steamcheng/esp8266_attic_monitor/schematics/Attic Monitor v3_schem.pdf

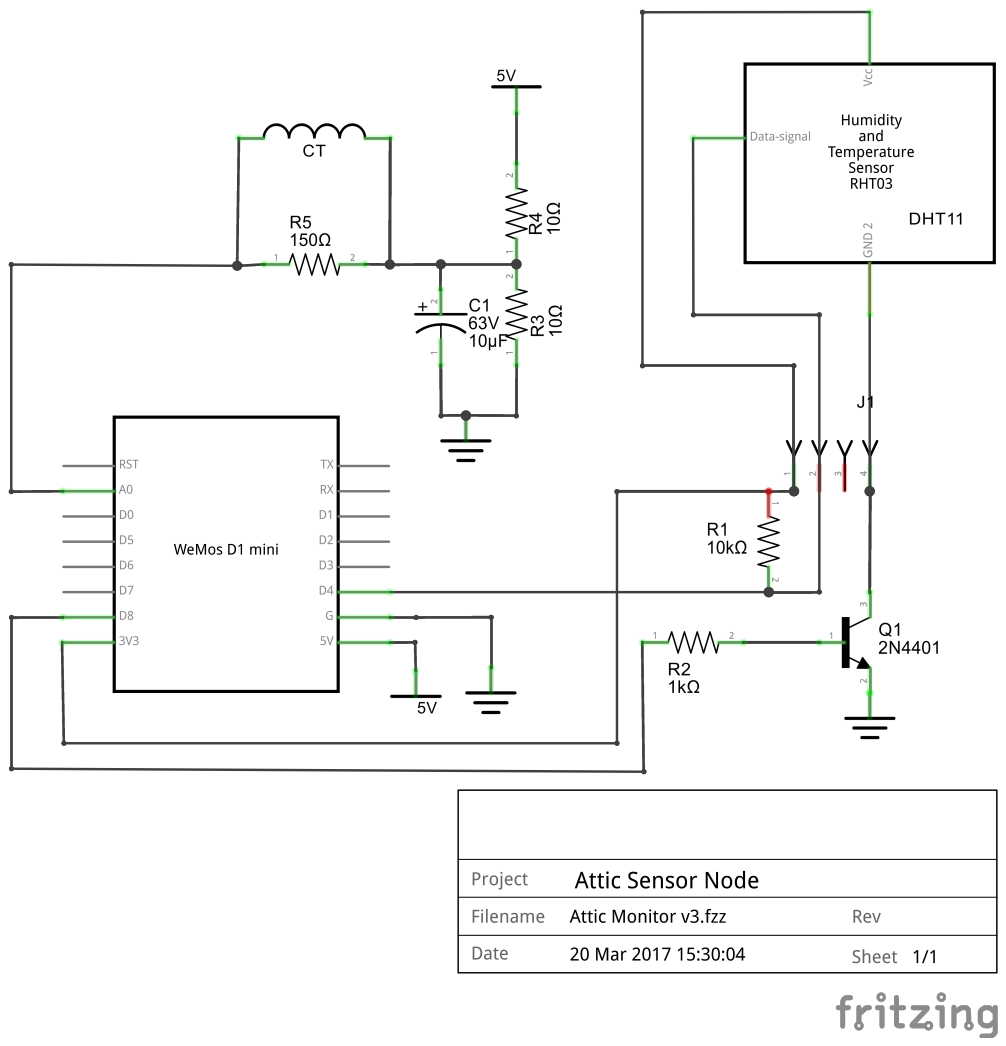
[picture p1: page 1]
