steamcheng/esp8266_attic_monitor/schematics/Attic Monitor Sketch_schem.pdf

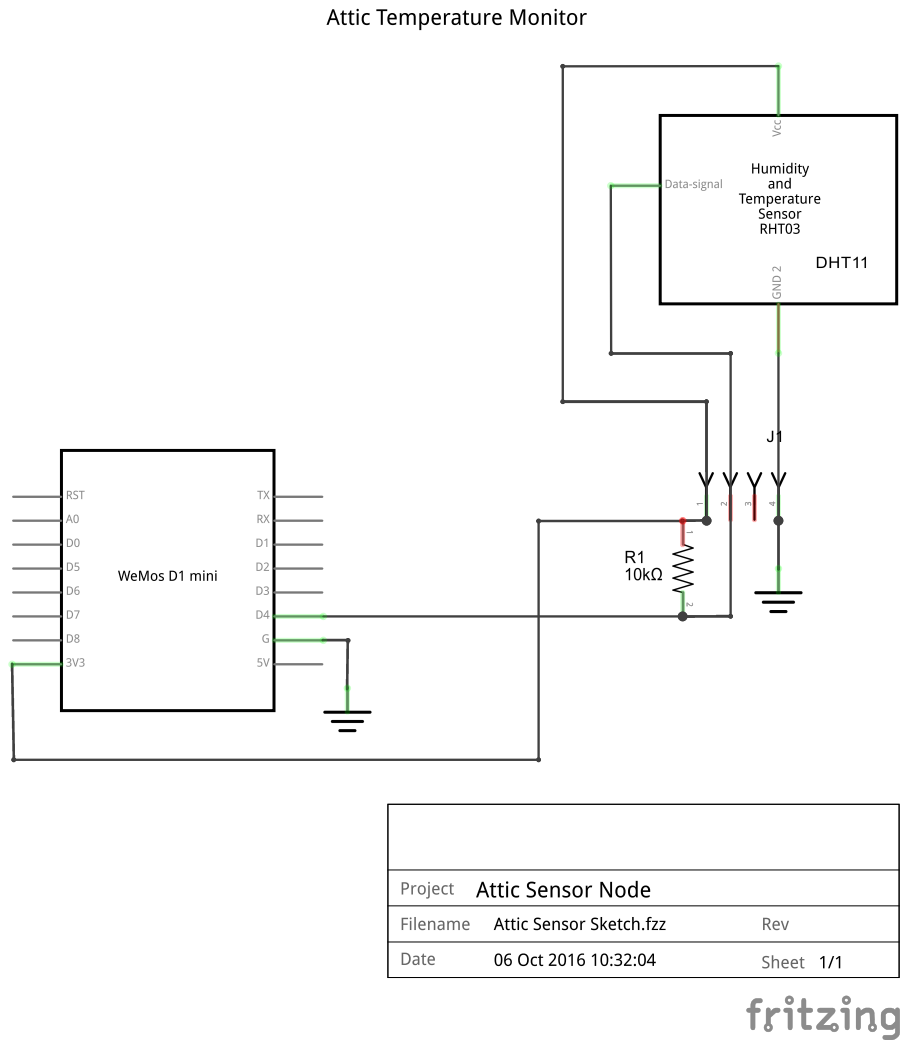
[picture p2: page 1]
