steamcheng/esp8266_attic_monitor/(commit log)

2016-10-06 Update attic_envmonitor.ino
    Removed references to BMP180 temp and pressure sensor. Removed orphaned code. Added more comments.
2017-03-28 Add files via upload
    Latest schematic which includes transistor to allow resetting the DHT sensor power and a current transformer to allow detection of attic vent fan running status.
2017-03-30 New features
    Updated with current monitor to detect attic vent fan status.
2017-03-31 Updated to reflect new features
    Added discussion of the overall device, the addition of fan status monitor and the DHT reset routine.
